canabis5w5/pinpointer/pcb/pinpointer.kicad_pcb

## KiCad design pcb/pinpointer.kicad_pcb (2023-10-08)

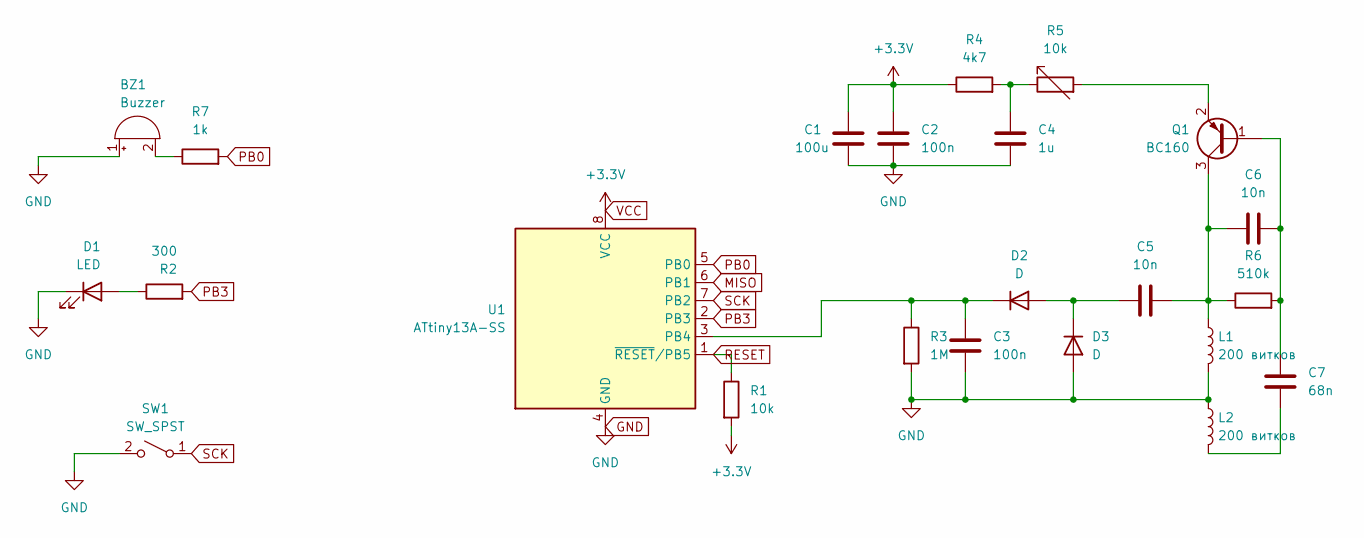
[picture p1: schematic pinpointer.kicad_sch]

Parts:
BZ1: Buzzer; R_Axial_DIN0207_L6.3mm_D2.5mm_P7.62mm_Horizontal
C1: 100u; C_1206_3216Metric
C2, C3: 100n; C_1206_3216Metric
C4: 1u; CP_EIA-3216-10_Kemet-I
C5, C6: 10n; C_1206_3216Metric
C7: 68n; C_1206_3216Metric
D1: LED; D_1206_3216Metric
D2, D3: D; D_1206_3216Metric
L1, L2: 200 витков; C_Radial_D6.3mm_H11.0mm_P2.50mm
Q1: BC160; SOT-23
R1, R5: 10k; R_1206_3216Metric
R2: 300; R_1206_3216Metric
R3: 1M; R_1206_3216Metric
R4: 4k7; R_1206_3216Metric
R6: 510k; R_1206_3216Metric
R7: 1k; R_1206_3216Metric
SW1: SW_SPST; SW_PUSH_6mm
U1: ATtiny13A-SS; SOIC-8_3.9x4.9mm_P1.27mm

Connections:
GND: BZ1.1 (-), C1.2, C2.2, C3.2, C4.2, D1.1 (K), D3.2 (A), L1.2, L2.1, R3.2, SW1.2 (B), U1.4 (GND)
MISO: U1.6 (PB1)
unnamed: BZ1.2 (+), R7.1
unnamed: C4.1, R4.2, R5.1
unnamed: C7.2, L2.2
unnamed: D1.2 (A), R2.1
unnamed: C5.1, D2.2 (A), D3.1 (K)
unnamed: C3.1, D2.1 (K), R3.1, U1.3 (PB4)
unnamed: C6.2, C7.1, Q1.1 (B), R6.2
unnamed: C5.2, C6.1, L1.1, Q1.3 (C), R6.1
unnamed: Q1.2 (E), R5.2
PB0: R7.2, U1.5 (PB0)
PB3: R2.2, U1.2 (PB3)
RESET: R1.1, U1.1 (~RESET/PB5)
SCK: SW1.1 (A), U1.7 (PB2)
VCC: C1.1, C2.1, R1.2, R4.1, U1.8 (VCC)

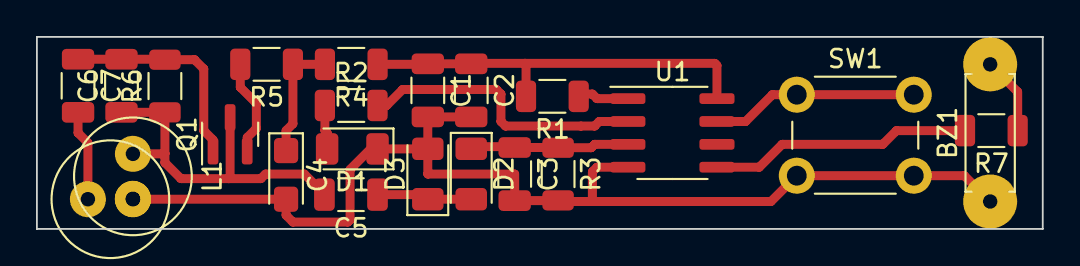
[picture p2: board pinpointer.kicad_pcb from above]

Board: 2 copper layers, 55.9 x 10.7 mm, 23 parts (0 on the bottom side), 15 nets.
